Darren-Lewis/SGX-VOX_amplifier_board/Oxygen sensor PCB V1.21/SGX-VOX amplifier board rev1.21.PNG

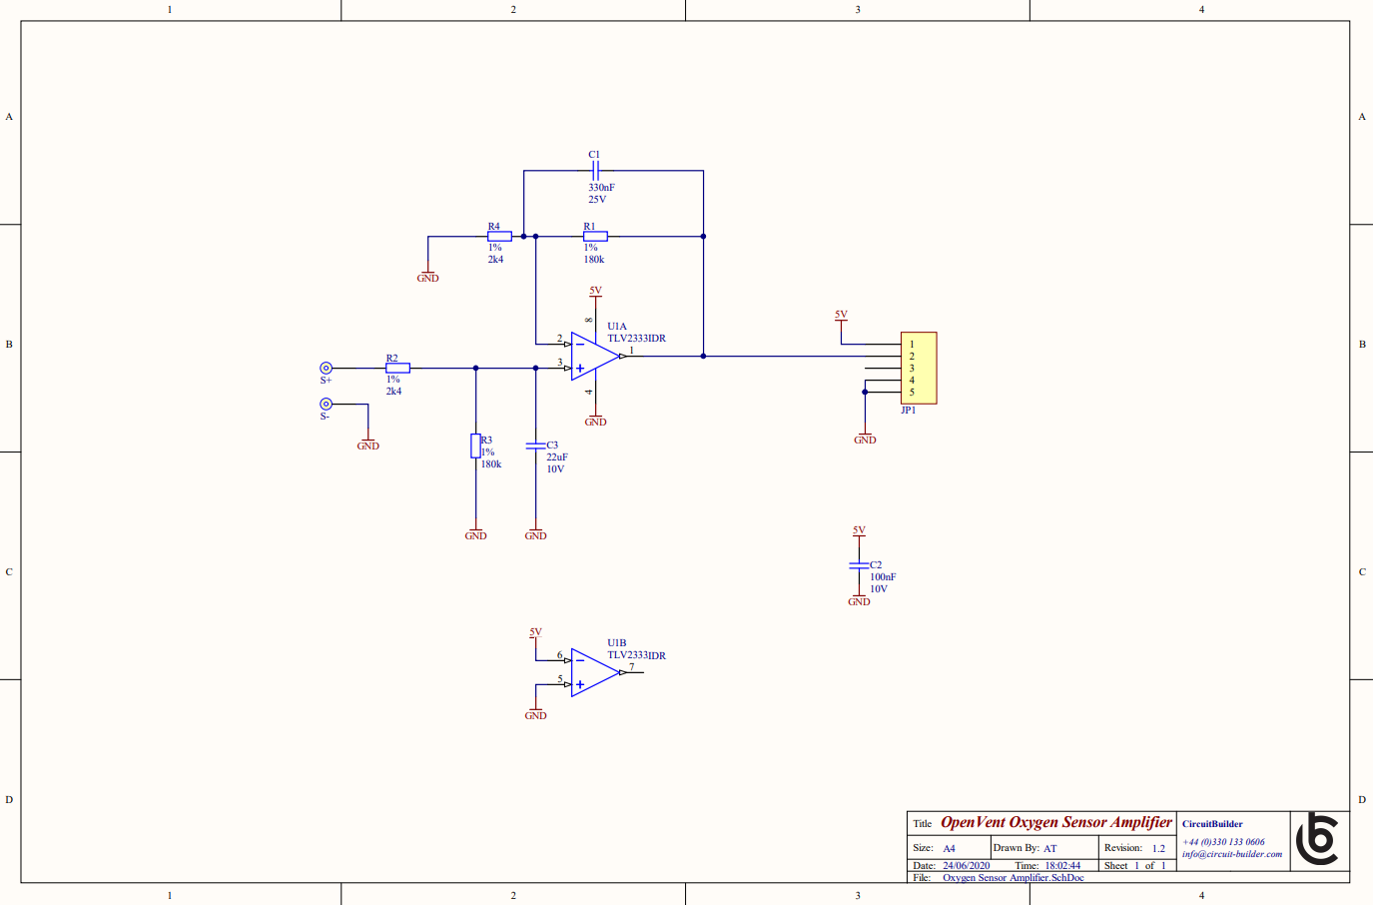
Oxygen sensor PCB V1.21/SGX-VOX amplifier board rev1.21.PNG
