Darren-Lewis/SGX-VOX_amplifier_board/Oxygen sensor PCB V1.21/Oxygen Sensor Amplifier BOM Rev 1.21.xls

Sheet: BOM
Bill of Materials
Source Data: | Oxygen Sensor Amplifier.PrjPcb
Project: | Oxygen Sensor Amplifier.PrjPcb
Variant: | None
Created: | 24/06/2020
Printed: | 2020-06-24 17:53
Designator | Quantity | Description | Value | Tolerance | Manufacturer | ManufacturerPN | Supplier1 | Supplier1PNProto | Cost
C1 | 1 | 330nF 0603 Ceramic Capacitor, 10%, 25V | 330nF | 10% | Guangdong Fenghua Advanced Tech | 0603B334K250NT | LCSC | C1615 | 0.08
C2 | 1 | 100nF 0603 Ceramic Capacitor, 10%, X7R, 25V | 100nF | 10% | Yageo | CC0603KRX7R9BB104 | LCSC | C14663 | 0.08
C3 | 1 | 22uF 0603 Ceramic Capacitor, 10%, 10V | 22uF | 10% | Samsung Electro-Mechanics | CL10A226MP8NUNE | LCSC | C86295 | 0.08
JP1 | 1 | 5 Position Header Connector Through Hole |  |  | Sullins Connector Solutions | PPTC051LFBN-RC | Digikey | S6103-ND‎ | 0.38
R1, R3 | 2 | 180k 0603 Chip Resistor, 1%, 0.1W | 180k | 1% | Uniroyal Elec | 0603WAF1803T5E | LCSC | C22827 | 0.08
R2, R4 | 2 | 2k4 0603 Chip Resistor, 1%, 0.1W | 2k4 | 1% | Uniroyal Elec | 0603WAF2401T5E | LCSC | C22940 | 0.08
U1 | 1 | Zero-Drift Amplifier 2 Circuit Rail-to-Rail 8-SOIC |  |  | Texas Instruments | TLV2333IDR | Digikey | 296-43772-1-ND

Sheet: Project Information
Project Filename | Oxygen Sensor Amplifier.PrjPcb
Variant Name | None
Data-Source Filename | Oxygen Sensor Amplifier.PrjPcb
Title | Prototype Bill of Materials For Project [Oxygen Sensor Amplifier.PrjPcb] (No PCB Document Selected)
Total Quantity | 9
Report Time | 17:51:05
Report Date | 24/06/2020
Report Date & Tine | 24/06/2020 17:51:05
Output Name | Prototype Bill of Materials
Output Type | BOM_PartType
Output Generator Name | BOM
Output Generator Description | Bill of Materials
