Darren-Lewis/SGX-VOX_amplifier_board/Oxygen sensor PCB V1.21/Oxygen Sensor Amplifier Schematics Rev 1.21.PDF

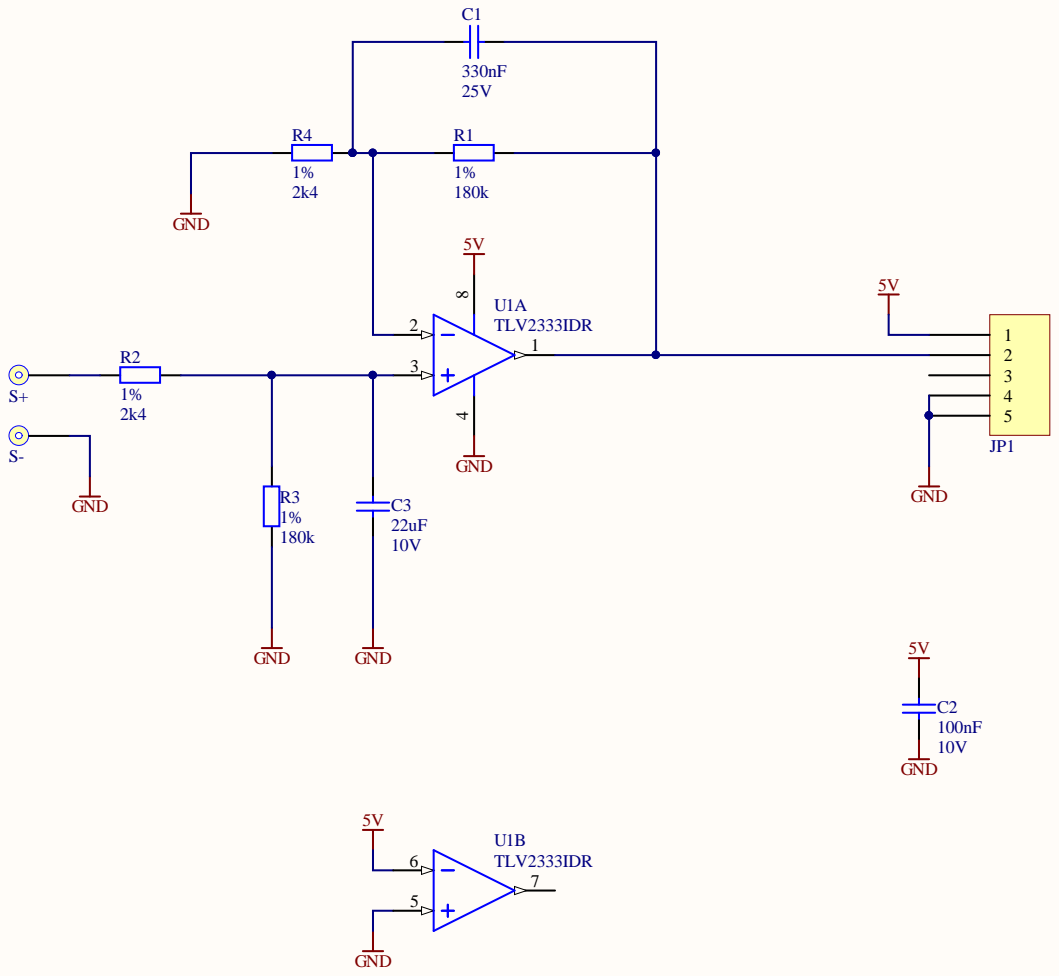
[picture p2: page 1]

OpenVent Oxygen Sensor Amplifier Title | CircuitBuilder +44 (0)330 133 0606 info@circuit-builder.com

Size: A4 | Drawn By: AT | Revision: 1.2
Date: 24/06/2020 Time: 18:02:44 | | Sheet 1 of 1

Oxygen Sensor Amplifier.SchDoc
