Darren-Lewis/SGX-VOX_amplifier_board/Oxygen sensor PCB V1.21/Oxygen Sensor Amplifier Copper Layer Drawings Rev 1.21.PDF

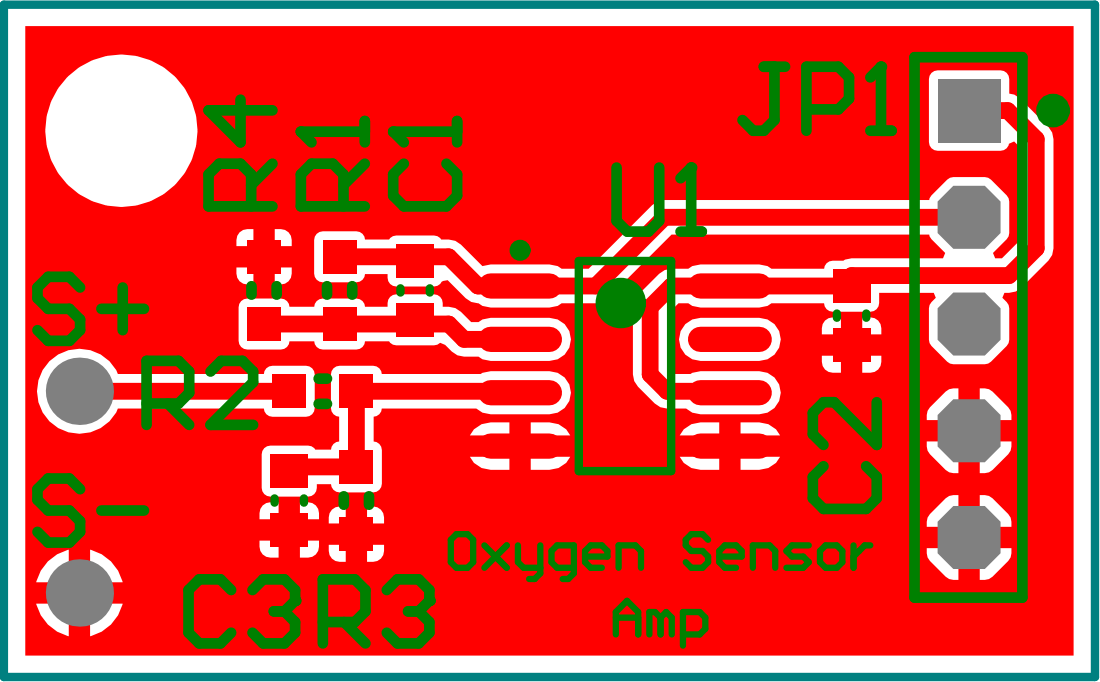
[picture p3: page 1]

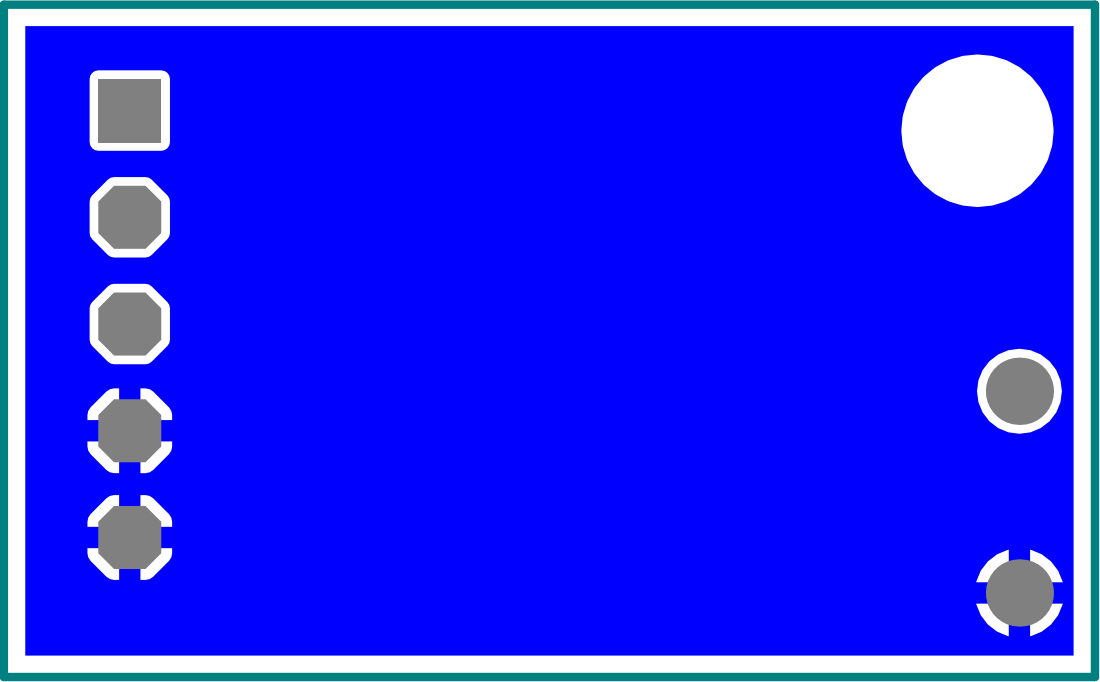
[picture p4: page 2]
