Darren-Lewis/SGX-VOX_amplifier_board/(commit log)

2021-02-01 PCB production files
    [Oxygen Sensor Amplifier BOM Rev 1.21.xls]
2021-02-01 Arduino code
